metastable/yosano-love-button/README.md

# yosano-love-button
Field hack YOSANO - oryza -  ♥yosano button
