metastable/yosano-love-button/Rev1/BOM.xlsx

Part | Value | Device | Package | Description | 名前 | MF | MPN | OC_AKIZUKI | OC_SENGOKU | OC_MARUTSU | 単価
C1 | 0.1uF | C5/2.5 | C5B2.5 | CAPACITOR | 絶縁ラジアルリード型積層セラミックコンデンサー０．１μＦ５０Ｖ５ｍｍ（１０個入） | 株式会社村田製作所(muRata) | RPEF11H104Z2K1A01B | P-02211 |  |  | 10
C2 | 22uF | C5/2.5 | C5B2.5 | CAPACITOR | 絶縁ラジアルリード型積層セラミックコンデンサ ２２μＦ５０Ｖ５ｍｍ | 株式会社村田製作所(muRata) | RDEC71H226MWK1H03B | P-08156 |  |  | 80
C3 | 1uF | C5/2.5 | C5B2.5 | CAPACITOR | 絶縁ラジアルリード型積層セラミックコンデンサ １μＦ５０Ｖ５ｍｍ | 株式会社村田製作所(muRata) | RDER71H105K2K1H03B | P-08150 |  |  | 20
C4 | 1uF | C5/2.5 | C5B2.5 | CAPACITOR | 絶縁ラジアルリード型積層セラミックコンデンサ １μＦ５０Ｖ５ｍｍ | 株式会社村田製作所(muRata) | RDER71H105K2K1H03B | P-08150 |  |  | 20
C5 | 10uF | C5/2.5 | C5B2.5 | CAPACITOR | 絶縁ラジアルリード型積層セラミックコンデンサ １０μＦ５０Ｖ５ｍｍ | 株式会社村田製作所(muRata) | RDEC71H106K3K1H03B | P-08155 |  |  | 50
C6 | 1uF | C5/2.5 | C5B2.5 | CAPACITOR | 絶縁ラジアルリード型積層セラミックコンデンサ １μＦ５０Ｖ５ｍｍ | 株式会社村田製作所(muRata) | RDER71H105K2K1H03B | P-08150 |  |  | 20
C7 | 1uF | C5/2.5 | C5B2.5 | CAPACITOR | 絶縁ラジアルリード型積層セラミックコンデンサ １μＦ５０Ｖ５ｍｍ | 株式会社村田製作所(muRata) | RDER71H105K2K1H03B | P-08150 |  |  | 20
C8 | 1uF | C5/2.5 | C5B2.5 | CAPACITOR | 絶縁ラジアルリード型積層セラミックコンデンサ １μＦ５０Ｖ５ｍｍ | 株式会社村田製作所(muRata) | RDER71H105K2K1H03B | P-08150 |  |  | 20
C9 | 1uF | C5/2.5 | C5B2.5 | CAPACITOR | 絶縁ラジアルリード型積層セラミックコンデンサ １μＦ５０Ｖ５ｍｍ | 株式会社村田製作所(muRata) | RDER71H105K2K1H03B | P-08150 |  |  | 20
CN1 | BUTTON1 | 04-JST-B4B-XH-A | B4B-XH | JST CONNECTOR | XHコネクタ 基板用ポスト 4P ストレート | 日本圧着端子製造(JST) | B4B-XH-A(LF)(SN) |  |  |  | 42
CN2 | BUTTON2 | 04-JST-B4B-XH-A | B4B-XH | JST CONNECTOR | XHコネクタ 基板用ポスト 4P ストレート | 日本圧着端子製造(JST) | B4B-XH-A(LF)(SN) |  |  |  | 42
CN3 | BUTTON3 | 04-JST-B4B-XH-A | B4B-XH | JST CONNECTOR | XHコネクタ 基板用ポスト 4P ストレート | 日本圧着端子製造(JST) | B4B-XH-A(LF)(SN) |  |  |  | 42
CN4 | I2C | GROVE-CONNECTOR-DIP(4P-2.0) | HW4-2.0 | Grove Connector | Grove用-4ピンコネクタ ストレート(オス)10個入り | Seeed Studio | 110990030 |  |  |  | 10
F1 | POLYSW-50mA RXEF005 | PTCPTH | PTC | Resettable Fuse PTC | ポリスイッチ５０ｍＡ（１００ｍＡで遮断） 耐圧：６０Ｖ ＲＸＥＦ００５ | Littelfuse, Inc./Tyco Electronics Corporation/Raychem | RXEF005 | P-01352 |  |  | 30
F2 | POLYSW-50mA RXEF005 | PTCPTH | PTC | Resettable Fuse PTC | ポリスイッチ５０ｍＡ（１００ｍＡで遮断） 耐圧：６０Ｖ ＲＸＥＦ００５ | Littelfuse, Inc./Tyco Electronics Corporation/Raychem | RXEF005 | P-01352 |  |  | 30
F3 | POLYSW-50mA RXEF005 | PTCPTH | PTC | Resettable Fuse PTC | ポリスイッチ５０ｍＡ（１００ｍＡで遮断） 耐圧：６０Ｖ ＲＸＥＦ００５ | Littelfuse, Inc./Tyco Electronics Corporation/Raychem | RXEF005 | P-01352 |  |  | 30
J1 | DC5V | POWER_JACK | POWER_JACK_PTH | Power Jack Connector | ２．１ｍｍ標準ＤＣジャック 基板取付用 ＭＪ－１７９Ｐ | マル信無線電機株式会社 | MJ-179P | C-00077 |  |  | 40
JP1 | SERIAL | PINHD-1X4 | 1X04 | PIN HEADER | 細ピンヘッダ １×４ | Useconn Electronics Ltd. | PHA-1x4SG | C-04392 |  |  | 5
LED1 |  | LED3MM | LED3MM | LED | ３ｍｍ赤色ＬＥＤ ７０° ＯＳＲ５ＪＡ３Ｚ７４Ａ | OptoSupply | OSR5JA3Z74A | I-11577 |  |  | 10
LED2 |  | LED3MM | LED3MM | LED | ３ｍｍ赤色ＬＥＤ ７０° ＯＳＲ５ＪＡ３Ｚ７４Ａ | OptoSupply | OSR5JA3Z74A | I-11577 |  |  | 10
LED3 |  | LED3MM | LED3MM | LED | ３ｍｍ赤色ＬＥＤ ７０° ＯＳＲ５ＪＡ３Ｚ７４Ａ | OptoSupply | OSR5JA3Z74A | I-11577 |  |  | 10
LED4 | POWER | LED3MM | LED3MM | LED | ３ｍｍ赤色ＬＥＤ ７０° ＯＳＲ５ＪＡ３Ｚ７４Ａ | OptoSupply | OSR5JA3Z74A | I-11577 |  |  | 10
Q1 | BS170 | BSS101 | TO92 | N-Channel Enhancement MOSFET 60V 0,5A | Ｎｃｈ ＭＯＳＦＥＴ ＢＳ１７０ | Fairchild Semiconductor | BSS170 | I-09724 |  |  | 20
Q2 | BS170 | BSS101 | TO92 | N-Channel Enhancement MOSFET 60V 0,5A | Ｎｃｈ ＭＯＳＦＥＴ ＢＳ１７０ | Fairchild Semiconductor | BSS170 | I-09724 |  |  | 20
Q3 | BS170 | BSS101 | TO92 | N-Channel Enhancement MOSFET 60V 0,5A | Ｎｃｈ ＭＯＳＦＥＴ ＢＳ１７０ | Fairchild Semiconductor | BSS170 | I-09724 |  |  | 20
R1 | 10K | R-US_0204/7 | 0204/7 | RESISTOR, American symbol | カーボン抵抗（炭素皮膜抵抗） １／４Ｗ １０ｋΩ （１００本入） | SHIH HAO Electronics CO.,LTD | RD25S 10K | R-25103 |  |  | 1
R2 | 10K | R-US_0204/7 | 0204/7 | RESISTOR, American symbol | カーボン抵抗（炭素皮膜抵抗） １／４Ｗ １０ｋΩ （１００本入） | SHIH HAO Electronics CO.,LTD | RD25S 10K | R-25103 |  |  | 1
R3 | 200K | R-US_0204/7 | 0204/7 | RESISTOR, American symbol | カーボン抵抗（炭素皮膜抵抗） １／４Ｗ ２００ｋΩ （１００本入） | SHIH HAO Electronics CO.,LTD | RD25S 200K | R-25204 |  |  | 1
R4 | 100K | R-US_0204/7 | 0204/7 | RESISTOR, American symbol | カーボン抵抗（炭素皮膜抵抗） １／４Ｗ １００ｋΩ （１００本入） | SHIH HAO Electronics CO.,LTD | RD25S 100K | R-25104 |  |  | 1
R5 | 330R | R-US_0204/7 | 0204/7 | RESISTOR, American symbol | カーボン抵抗（炭素皮膜抵抗） １／４Ｗ ３３０Ω （１００本入） | FAITHFUL LINK INDUSTRIAL CORP. | CF25J330RB | R-25331 |  |  | 1
R6 | 330R | R-US_0204/7 | 0204/7 | RESISTOR, American symbol | カーボン抵抗（炭素皮膜抵抗） １／４Ｗ ３３０Ω （１００本入） | FAITHFUL LINK INDUSTRIAL CORP. | CF25J330RB | R-25331 |  |  | 1
R7 | 10K | R-US_0204/7 | 0204/7 | RESISTOR, American symbol | カーボン抵抗（炭素皮膜抵抗） １／４Ｗ １０ｋΩ （１００本入） | SHIH HAO Electronics CO.,LTD | RD25S 10K | R-25103 |  |  | 1
R8 | 10K | R-US_0204/7 | 0204/7 | RESISTOR, American symbol | カーボン抵抗（炭素皮膜抵抗） １／４Ｗ １０ｋΩ （１００本入） | SHIH HAO Electronics CO.,LTD | RD25S 10K | R-25103 |  |  | 1
R9 | 10K | R-US_0204/7 | 0204/7 | RESISTOR, American symbol | カーボン抵抗（炭素皮膜抵抗） １／４Ｗ １０ｋΩ （１００本入） | SHIH HAO Electronics CO.,LTD | RD25S 10K | R-25103 |  |  | 1
R10 | 0R | R-US_0204/7 | 0204/7 | RESISTOR, American symbol | カーボン抵抗（炭素皮膜抵抗） １／４Ｗ ０Ω （１００本入） | SHIH HAO Electronics CO.,LTD | RD25S 0E | R-25000 |  |  | 1
R11 | 10K | R-US_0204/7 | 0204/7 | RESISTOR, American symbol | カーボン抵抗（炭素皮膜抵抗） １／４Ｗ １０ｋΩ （１００本入） | SHIH HAO Electronics CO.,LTD | RD25S 10K | R-25103 |  |  | 1
R12 | 10K | R-US_0204/7 | 0204/7 | RESISTOR, American symbol | カーボン抵抗（炭素皮膜抵抗） １／４Ｗ １０ｋΩ （１００本入） | SHIH HAO Electronics CO.,LTD | RD25S 10K | R-25103 |  |  | 1
R13 | 0R | R-US_0204/7 | 0204/7 | RESISTOR, American symbol | カーボン抵抗（炭素皮膜抵抗） １／４Ｗ ０Ω （１００本入） | SHIH HAO Electronics CO.,LTD | RD25S 0E | R-25000 |  |  | 1
R14 | 10K | R-US_0204/7 | 0204/7 | RESISTOR, American symbol | カーボン抵抗（炭素皮膜抵抗） １／４Ｗ １０ｋΩ （１００本入） | SHIH HAO Electronics CO.,LTD | RD25S 10K | R-25103 |  |  | 1
R15 | 10K | R-US_0204/7 | 0204/7 | RESISTOR, American symbol | カーボン抵抗（炭素皮膜抵抗） １／４Ｗ １０ｋΩ （１００本入） | SHIH HAO Electronics CO.,LTD | RD25S 10K | R-25103 |  |  | 1
R16 | 0R | R-US_0204/7 | 0204/7 | RESISTOR, American symbol | カーボン抵抗（炭素皮膜抵抗） １／４Ｗ ０Ω （１００本入） | SHIH HAO Electronics CO.,LTD | RD25S 0E | R-25000 |  |  | 1
R17 | 10K | R-US_0204/7 | 0204/7 | RESISTOR, American symbol | カーボン抵抗（炭素皮膜抵抗） １／４Ｗ １０ｋΩ （１００本入） | SHIH HAO Electronics CO.,LTD | RD25S 10K | R-25103 |  |  | 1
R18 | 330R | R-US_0204/7 | 0204/7 | RESISTOR, American symbol | カーボン抵抗（炭素皮膜抵抗） １／４Ｗ ３３０Ω （１００本入） | FAITHFUL LINK INDUSTRIAL CORP. | CF25J330RB | R-25331 |  |  | 1
R19 | 330R | R-US_0204/7 | 0204/7 | RESISTOR, American symbol | カーボン抵抗（炭素皮膜抵抗） １／４Ｗ ３３０Ω （１００本入） | FAITHFUL LINK INDUSTRIAL CORP. | CF25J330RB | R-25331 |  |  | 1
R20 | 330R | R-US_0204/7 | 0204/7 | RESISTOR, American symbol | カーボン抵抗（炭素皮膜抵抗） １／４Ｗ ３３０Ω （１００本入） | FAITHFUL LINK INDUSTRIAL CORP. | CF25J330RB | R-25331 |  |  | 1
R21 | 330R | R-US_0204/7 | 0204/7 | RESISTOR, American symbol | カーボン抵抗（炭素皮膜抵抗） １／４Ｗ ３３０Ω （１００本入） | FAITHFUL LINK INDUSTRIAL CORP. | CF25J330RB | R-25331 |  |  | 1
SW1 | RESET | TVBP06 | TVBP06 | 2pin switch. | タクトスイッチ（黒） | Zhejiang Jianfu Electronics Co., Ltd | TVBP06-B043CB-B | P-08073 |  |  | 20
SW2 | BOOT | TVBP06 | TVBP06 | 2pin switch. | タクトスイッチ（黒） | Zhejiang Jianfu Electronics Co., Ltd | TVBP06-B043CB-B | P-08073 |  |  | 20
U1 | ESP-WROOM-02FRONT-FACE | ESP-WROOM-02FRONT-FACE | FRONT-FACE | WiFi module - ESP-WROOM-02 | Ｗｉ－Ｆｉモジュール ＥＳＰ－ＷＲＯＯＭ－０２ | Espressif Systems (Shanghai) Pte. Ltd. | ESP-WROOM-02 | M-09607 |  |  | 550
U2 | TA48M033F | TA48M033F | DPACK | TA48 series | 低損失三端子レギュレーター ３．３Ｖ５００ｍＡ ＴＡ４８Ｍ０３３Ｆ（Ｓ Ｑ） | 株式会社東芝セミコンダクター社(TOSHIBA) | TA48M033F(S Q) | I-00538 |  |  | 100
U3 | TCM809R | TCM809 | SOT23B-3 | POWER SUPPLY MONITOR | リセットＩＣ ＴＣＭ８０９Ｒ（８個入） | Microchip Technology Inc.(マイクロチップ) | TCM809RVNB | I-02533 |  |  | 25
GOLD_ORB_SM1 | OSHWLOGOLOGO5MM | OSHWLOGOLOGO5MM | OSHW_5MM | The OSHW logo for PCB layout |  |  |  |  |  |  | 0
PCB1 | PCB_DP_RECTANGLE-37X60 | PCB_DP_RECTANGLE-37X60 | DP6037_V1 | Dangerous Prototypes Standard Rectangular PCB sizes |  | PCBGOGO | B67668AS3 60 x 37 |  |  |  | 540.8
 |  |  |  |  | 照光式ゲームスイッチ 30Φ レッド | セイミツ工業 | PSL-30N-5W2-R |  | EEHD-0PLA |  | 1061
 |  |  |  |  | 照光式ゲームスイッチ 30Φ オレンジ | セイミツ工業 | PSL-30N-5W2-O |  | EEHD-0SMS |  | 1061
 |  |  |  |  | 照光式ゲームスイッチ 30Φ ブルー | セイミツ工業 | PSL-30N-5W2-B |  | EEHD-0PLD |  | 1061
 |  |  |  |  | XHコネクタ コンタクト(10個入)【SXH-001T-0.6*10】 | 日本圧着端子製造(JST) | SXH-001T-0.6*10 |  |  | 59201 | 180
 |  |  |  |  | XHコネクタ コンタクト(10個入)【SXH-001T-0.6*10】 | 日本圧着端子製造(JST) | SXH-001T-0.6*10 |  |  | 59201 | 180
 |  |  |  |  | 長方形コネクタ-ハウジング【XHP-4】 | 日本圧着端子製造(JST) | XHP-4 |  |  | 14896331 | 40
 |  |  |  |  | 長方形コネクタ-ハウジング【XHP-4】 | 日本圧着端子製造(JST) | XHP-4 |  |  | 14896331 | 40
 |  |  |  |  | 長方形コネクタ-ハウジング【XHP-4】 | 日本圧着端子製造(JST) | XHP-4 |  |  | 14896331 | 40
 |  |  |  |  | プラスチックケース | タカチ電機 | SW-125B |  | 757L-64F7 |  | 270
 |  |  |  |  |  |  |  |  |  |  | 5840.8
