metastable/yosano-love-button/Rev1/case/CaseProcessingInstruction.dxf

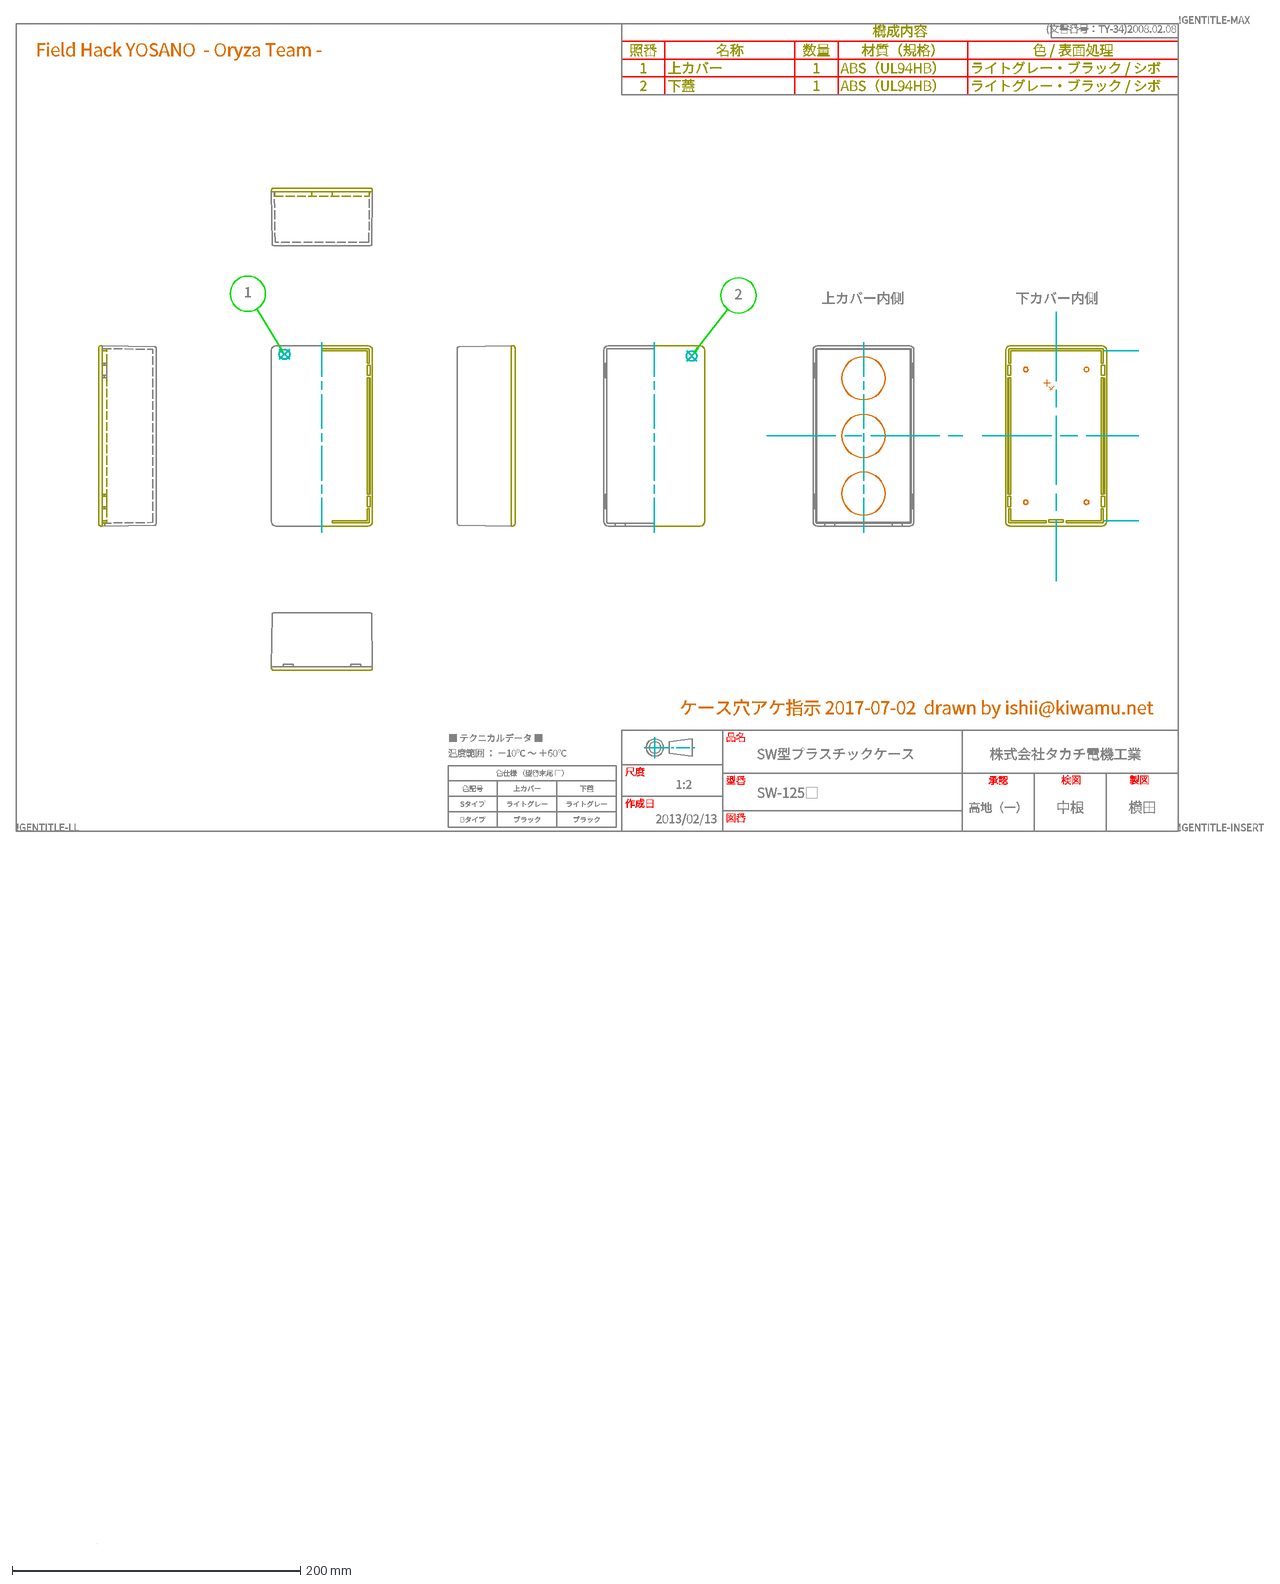
[picture p1: CAD file, 2017-07-02, an earlier design]
Rev1/case/CaseProcessingInstruction.dxf
(文書番号：TY-34)2008.02.08
!GENTITLE-INSERT
!GENTITLE-LL
!GENTITLE-MAX
2013/02/13
SW型プラスチックケース
SW-125□
高地（一）
中根
横田
1:2
製図
検図
承認
株式会社タカチ電機工業
品名
型番
図番
尺度
作成日
1
2
上カバー
ABS（UL94HB）
ライトグレー・ブラック / シボ
下蓋
照番
名称
数量
材質（規格）
色 / 表面処理
構成内容
上カバー内側
下カバー内側
■ テクニカルデータ ■
温度範囲 ： －10℃ ～ ＋60℃
色仕様 （型番末尾 □）
色記号
Sタイプ
ライトグレー
Bタイプ
ブラック
×4
ケース穴アケ指示 2017-07-02 drawn by ishii@kiwamu.net
Field Hack YOSANO - Oryza Team -
