metastable/yosano-love-button/Rev1/eagle/YosanoLoveButton-Schematic.pdf

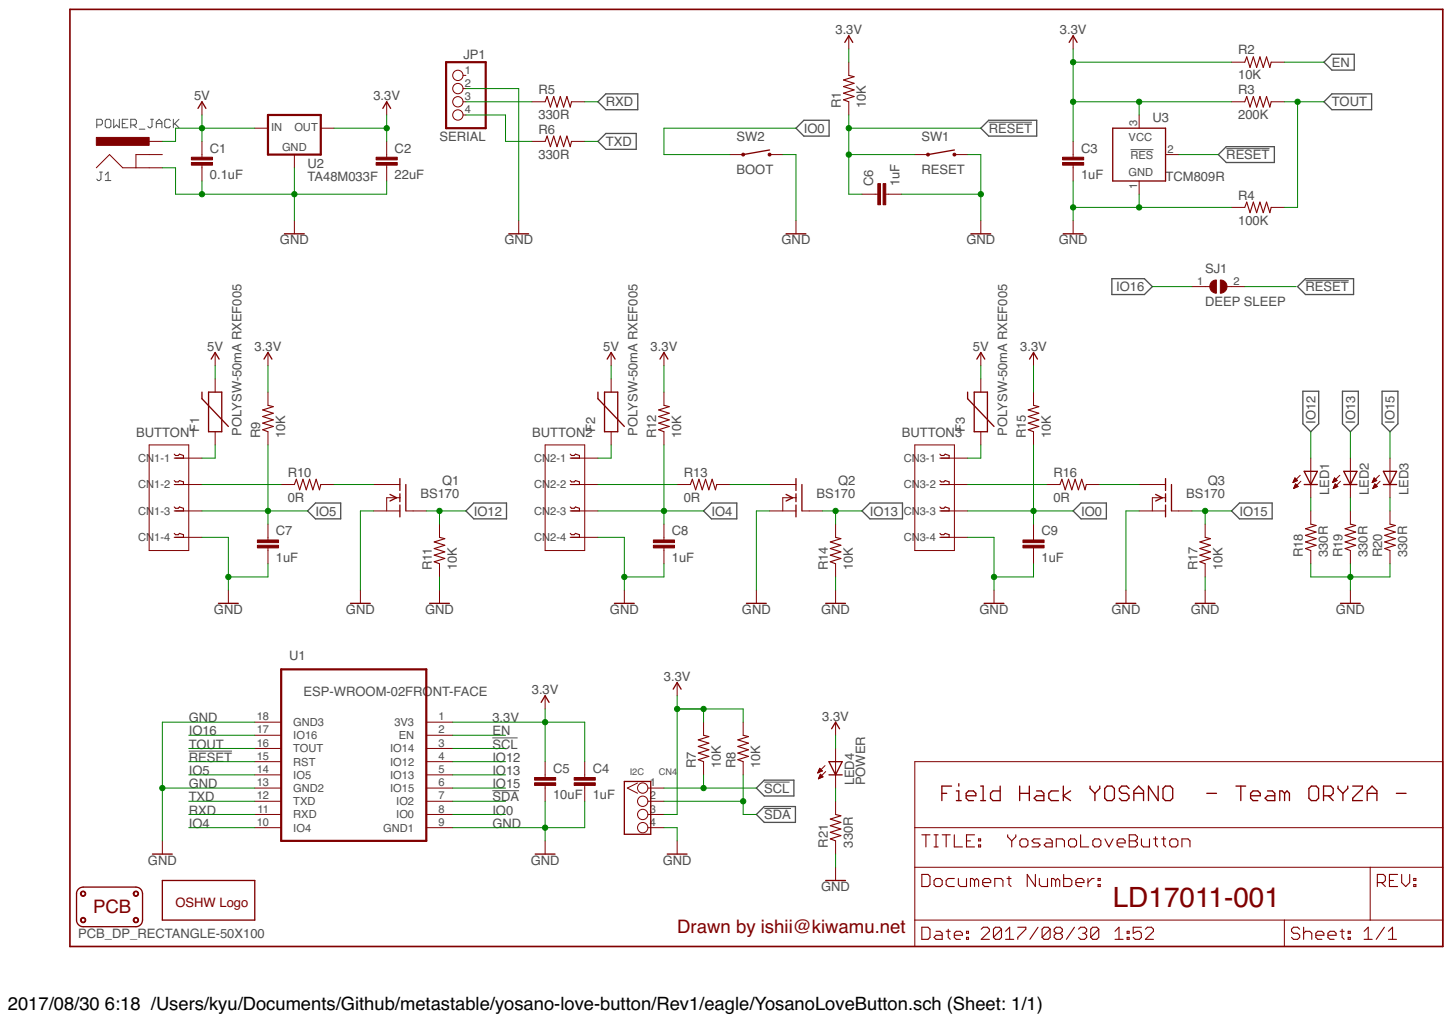
[picture p2: page 1]

Drawn by ishii@kiwamu.net

2017/08/30 6:18 /Users/kyu/Documents/Github/metastable/yosano-love-button/Rev1/eagle/YosanoLoveButton.sch (Sheet: 1/1)
