metastable/yosano-love-button/Rev2/eagle/YosanoLoveButton-Schematic.pdf

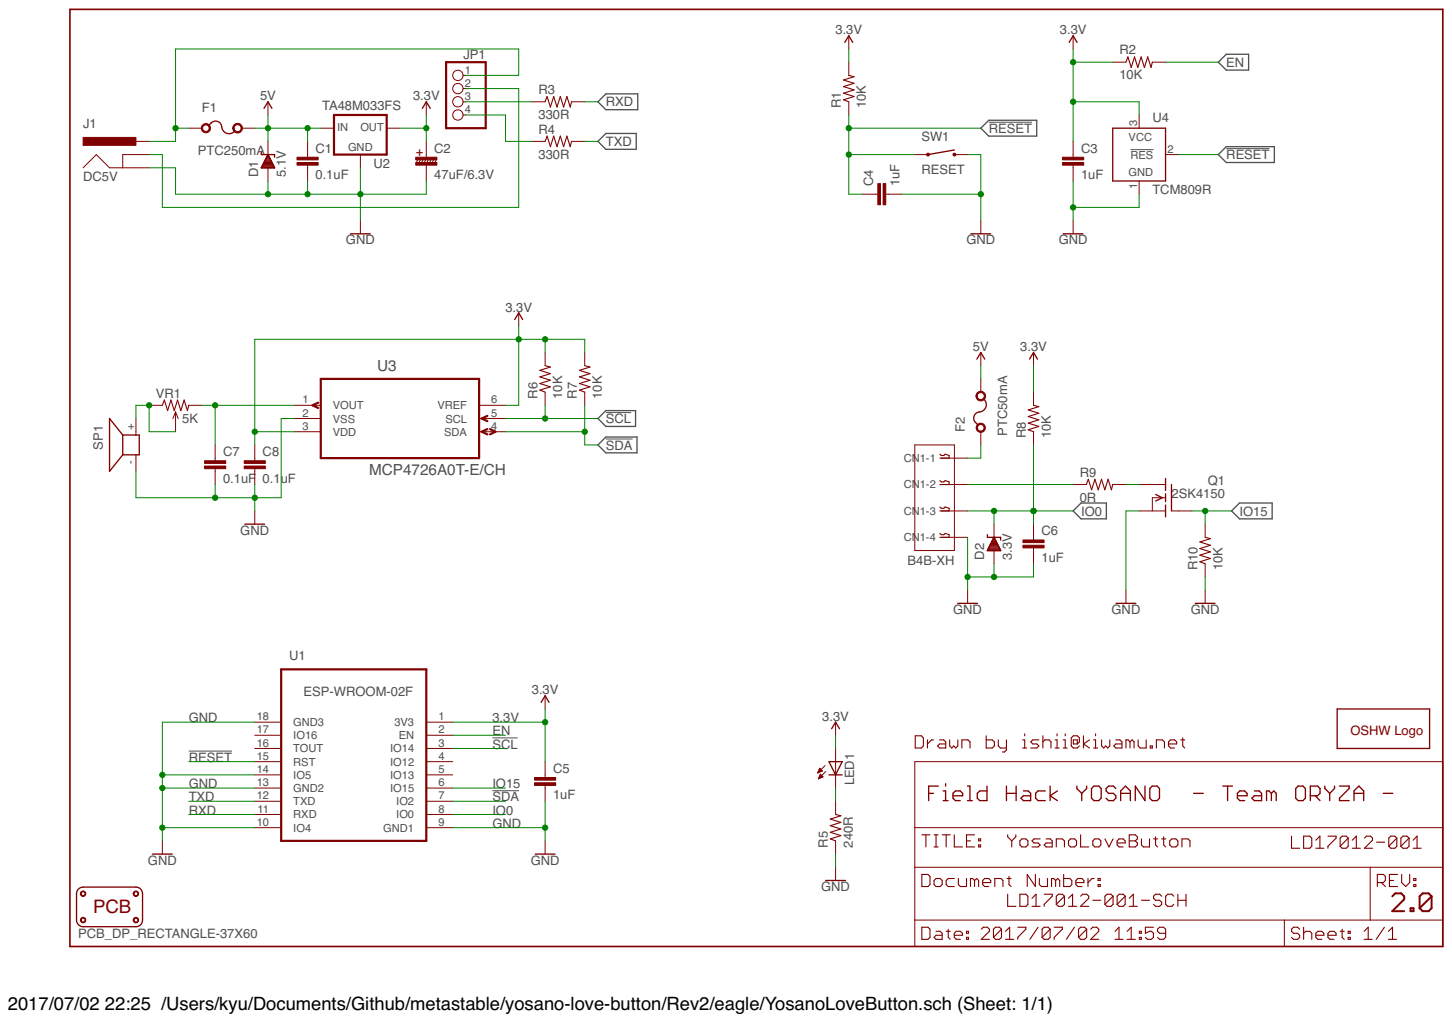
[picture p3: page 1]

2017/07/02 22:25 /Users/kyu/Documents/Github/metastable/yosano-love-button/Rev2/eagle/YosanoLoveButton.sch (Sheet: 1/1)
