metastable/yosano-love-button/Rev1/eagle/YosanoLoveButtonBottom.pdf

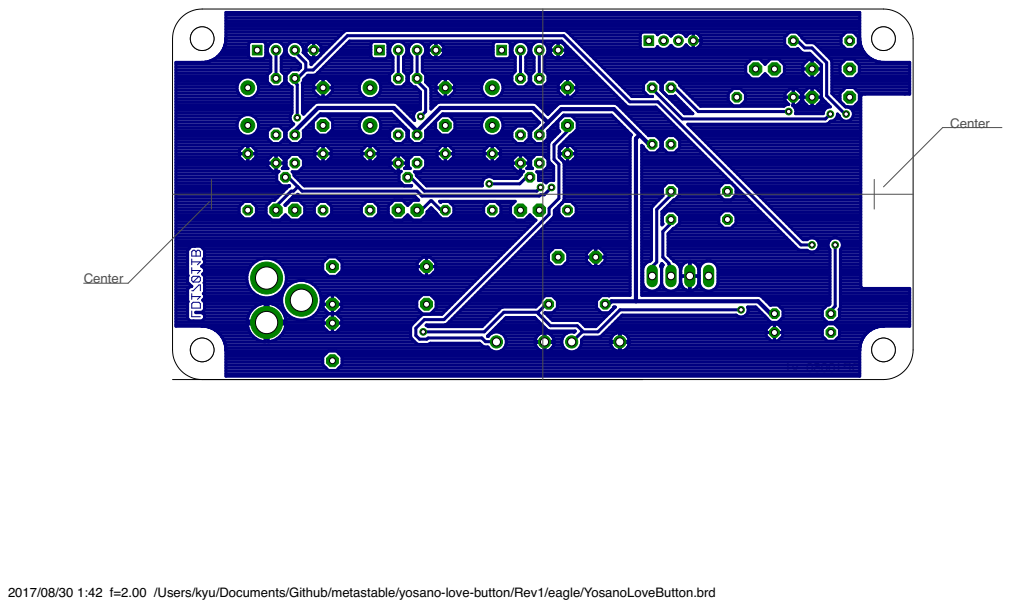
[picture p4: page 1]

2017/08/30 1:42 f=2.00 /Users/kyu/Documents/Github/metastable/yosano-love-button/Rev1/eagle/YosanoLoveButton.brd
