metastable/yosano-love-button/Rev2/eagle/YosanoLoveButton-Board.pdf

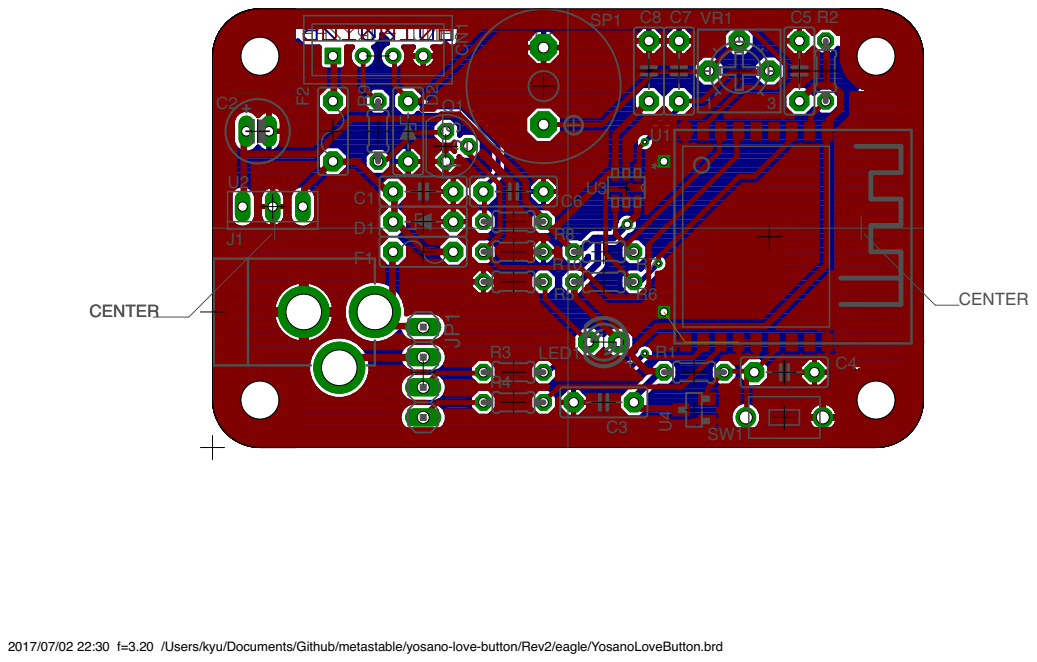
[picture p5: page 1]

2017/07/02 22:30 f=3.20 /Users/kyu/Documents/Github/metastable/yosano-love-button/Rev2/eagle/YosanoLoveButton.brd
