metastable/yosano-love-button/Rev1/case/CaseProcessingInstruction.pdf

### Field Hack YOSANO - Oryza Team -

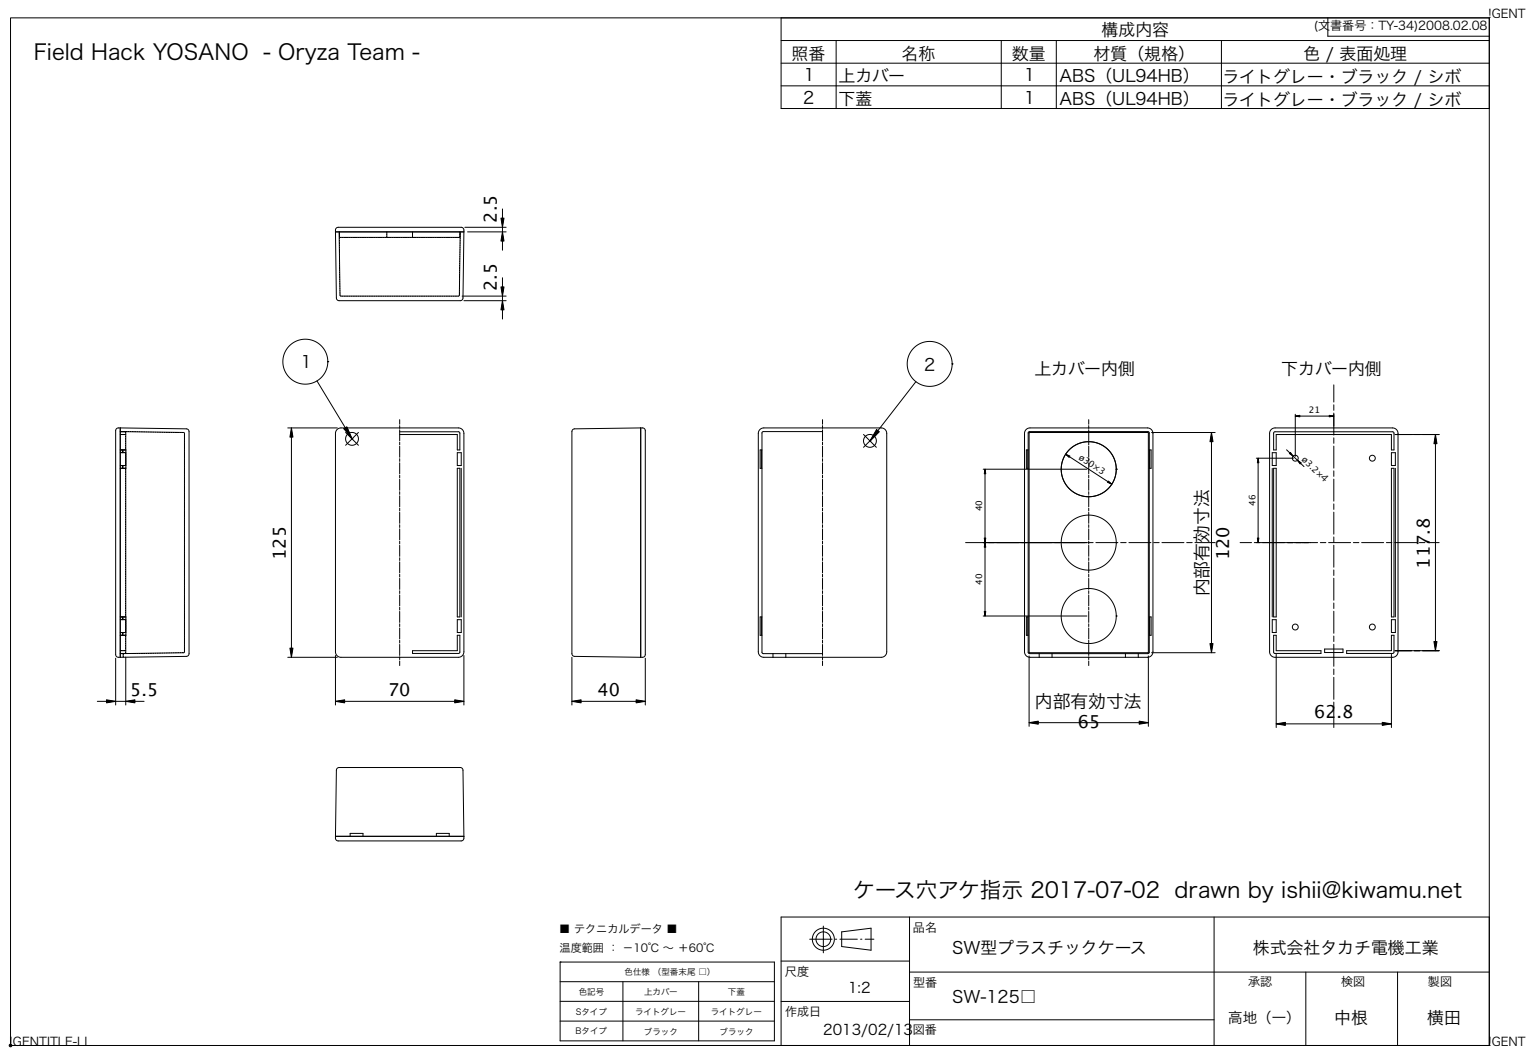
[picture p6: page 1]
(⽂書番号：TY-34)2008.02.08; !GENTITLE-LL; !GENTITLE-INSERT; !GENTITLE-MAX; 構成内容; 内部有効⼨法; 上カバー内側; 下カバー内側; ■ テクニカルデータ ■; 温度範囲 ： －10℃ 〜 ＋60℃; ⾊仕様 （型番末尾 □）; 上カバー; Sタイプ; ライトグレー; Bタイプ; ブラック

照番 | 名称 | 数量 | 材質（規格） | ⾊ / 表⾯処理
1 | 上カバー | 1 | ABS（UL94HB） | ライトグレー・ブラック / シボ
2 | 下蓋 | 1 | ABS（UL94HB） | ライトグレー・ブラック / シボ

ケース⽳アケ指⽰ 2017-07-02 drawn by ishii@kiwamu.net

品名 SW型プラスチックケース | 株式会社タカチ電機⼯業
