metastable/yosano-love-button/Rev3/eagle/YosanoLoveButton.brd

## EAGLE design Rev3/eagle/YosanoLoveButton.brd (2017-08-29)

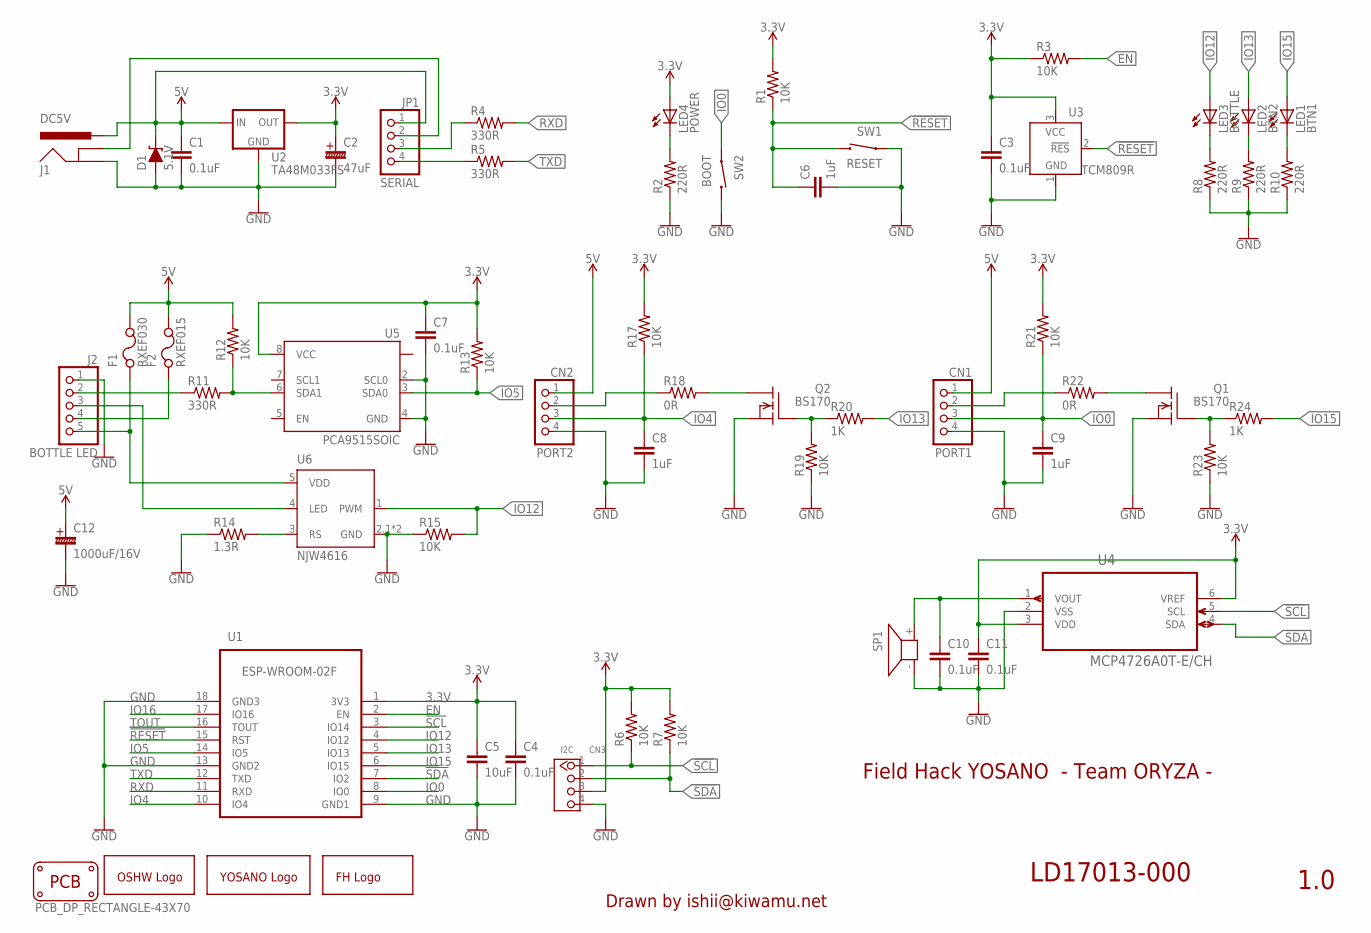
[picture p7: schematic YosanoLoveButton.sch]

Parts:
C1, C3, C4, C7: 0.1uF; C5B2.5
C2: 47uF; E2,0-5
C5: 10uF; C5B2.5
C6, C8, C9: 1uF; C5B2.5
C10, C11: 0.1uF; C5B2.5; MPN RDER72E104K2K1H03B
C12: 1000uF/16V; E5,0-10
CN1: PORT1; B4B-XH
CN2: PORT2; B4B-XH
CN3: I2C; HW4-2.0
D1: 5.1V; ZDIO-5-LD
F1: RXEF030; PTC-PTH
F2: RXEF015; PTC-PTH
GOLD_ORB_SM1: OSHWLOGOLOGO5MM; OSHW_5MM
J1: DC5V; POWER_JACK_PTH
J2: BOTTLE LED; MD-50SM
JP1: SERIAL; 1X04
LED1: BTN1; LED3MM
LED2: BTN2; LED3MM
LED3: BOTTLE; LED3MM
LED4: POWER; LED3MM
PCB1: PCB_DP_RECTANGLE-43X70; DP7043_V1
Q1, Q2: BS170; TO92
R1, R3, R6, R7, R12, R13, R15, R17, R19, R21, R23: 10K; 0204/5
R2, R8, R9, R10: 220R; 0204/5
R4, R5, R11: 330R; 0204/5
R14: 1.3R; 0204/5
R18, R22: 0R; 0204/5
R20, R24: 1K; 0204/5
SP1: PKM13EPYH4000
SW1: RESET; TVBP06
SW2: BOOT; TVBP06
U1: ESP-WROOM-02F; FRONT-FACE
U2: TA48M033FS; HSIP3
U3: TCM809R; SOT23B-3
U4: MCP4726A0T-E/CH; SOT95P270X145-6N
U5: PCA9515SOIC; SO08
U6: NJW4616; SOT-89-5
U$1: YOSANOLOGO; YOSANOCHO
U$2: FHLOGO; FIELDHACK-YOSANO

Connections:
3.3V: C2.+, C3.1, C4.1, C5.1, C7.1, C11.1, CN3.3, LED4.A, R1.2, R3.1, R6.2, R7.2, R13.2, R17.2, R21.2, U1.1 (3V3), U2.P$2 (OUT), U3.3 (VCC), U4.3 (VDD), U4.6 (VREF), U5.8 (VCC)
5V: C1.1, C12.+, CN1.1, CN2.1, D1.C, F1.2, F2.2, J1.PWR, JP1.1, R12.2, U2.P$1 (IN)
!RESET: C6.1, R1.1, SW1.2, U1.15 (RST), U3.2 (!RES)
!SCL: CN3.1, R6.1, U1.3 (IO14), U4.5 (SCL)
!SDA: CN3.2, R7.1, U1.7 (IO2), U4.4 (SDA)
EN: R3.2, U1.2 (EN)
GND: C1.2, C2.-, C3.2, C4.2, C5.2, C6.2, C7.2, C8.2, C9.2, C10.2, C11.2, C12.-, CN1.4, CN2.4, CN3.4, D1.A, J1.GND, J2.1, Q1.1 (S), Q2.1 (S), R2.1, R8.1, R9.1, R10.1, R14.1, R15.1, R19.1, R23.1, SP1.- (2), SW1.1, SW2.2, U1.9 (GND1), U1.13 (GND2), U1.18 (GND3), U2.P$3 (GND), U3.1 (GND), U4.2 (VSS), U5.2 (SCL0), U5.4 (GND), U6.2.1 (GND), U6.2.2 (GND)
IO0: C9.1, CN1.3, R21.1, SW2.1, U1.8 (IO0)
IO4: C8.1, CN2.3, R17.1, U1.10 (IO4)
IO5: R13.1, U1.14 (IO5), U5.3 (SDA0)
IO12: LED3.A, R15.2, U1.4 (IO12), U6.1 (PWM)
IO13: LED2.A, R20.2, U1.5 (IO13)
IO15: LED1.A, R24.2, U1.6 (IO15)
IO16: U1.17 (IO16)
unnamed: LED3.K (C), R8.2
unnamed: LED4.K (C), R2.2
unnamed: JP1.4, R5.1
unnamed: R14.2, U6.3 (RS)
unnamed: JP1.3, R4.1
unnamed: LED2.K (C), R9.2
unnamed: LED1.K (C), R10.2
unnamed: F1.1, J2.5, U6.5 (VDD)
unnamed: J2.3, U6.4 (LED)
unnamed: J1.GNDBREAK, JP1.2
unnamed: Q2.3 (D), R18.2
unnamed: J2.2, R11.1
unnamed: CN2.2, R18.1
unnamed: Q2.2 (G), R19.2, R20.1
unnamed: Q1.3 (D), R22.2
unnamed: C10.1, SP1.+ (1), U4.1 (VOUT)
unnamed: F2.1, J2.4
unnamed: Q1.2 (G), R23.2, R24.1
unnamed: CN1.2, R22.1
unnamed: R11.2, R12.1, U5.6 (SDA1)
RXD: R4.2, U1.11 (RXD)
TOUT: U1.16 (TOUT)
TXD: R5.2, U1.12 (TXD)

Notes on the sheet:
Field Hack YOSANO - Team ORYZA -
LD17013-000
Drawn by ishii@kiwamu.net
1.0

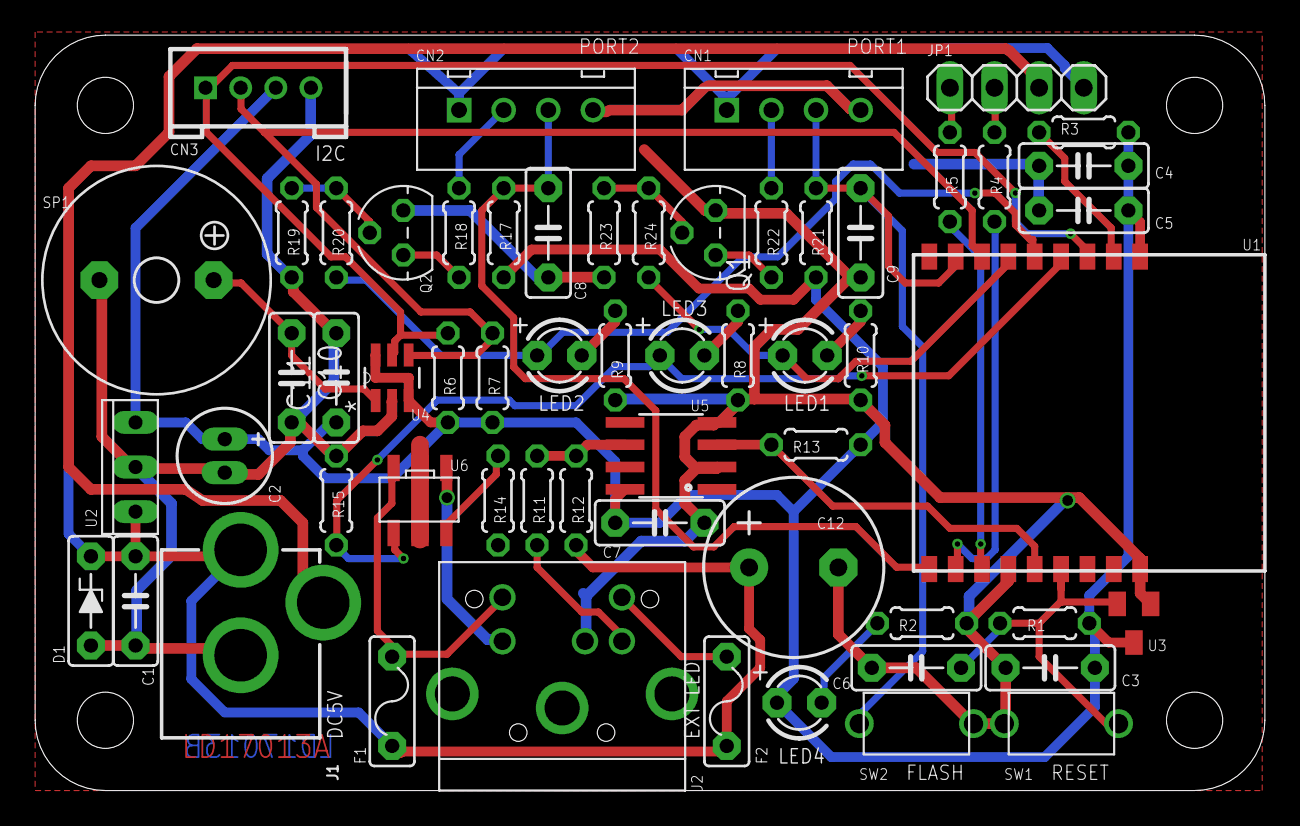
[picture p8: board Rev3/eagle/YosanoLoveButton.brd from above]

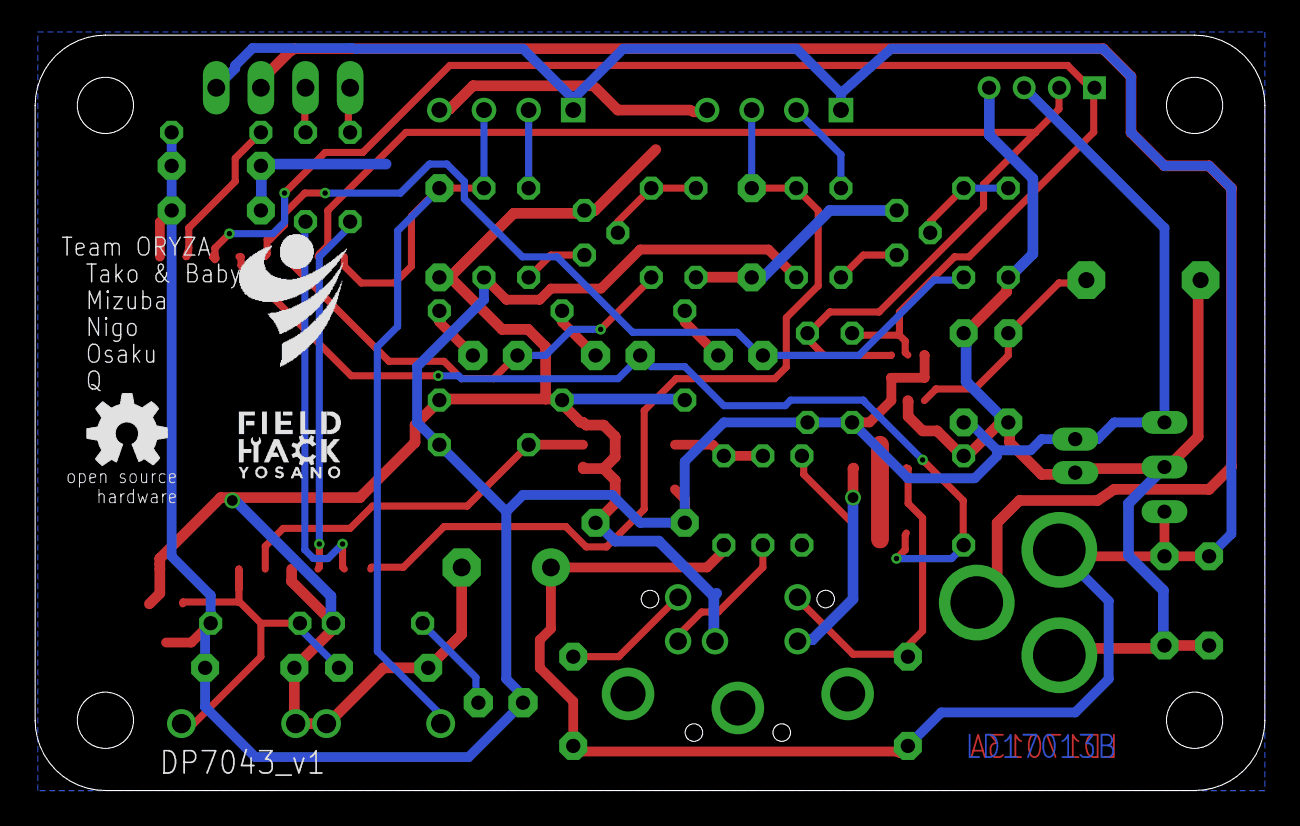
[picture p9: board Rev3/eagle/YosanoLoveButton.brd from below]

Board: 2 copper layers, 70.0 x 43.0 mm, 63 parts (3 on the bottom side), 35 nets.
