metastable/yosano-love-button/Rev1/eagle/YosanoLoveButton.brd

## EAGLE design Rev1/eagle/YosanoLoveButton.brd (2017-07-02, an earlier design)

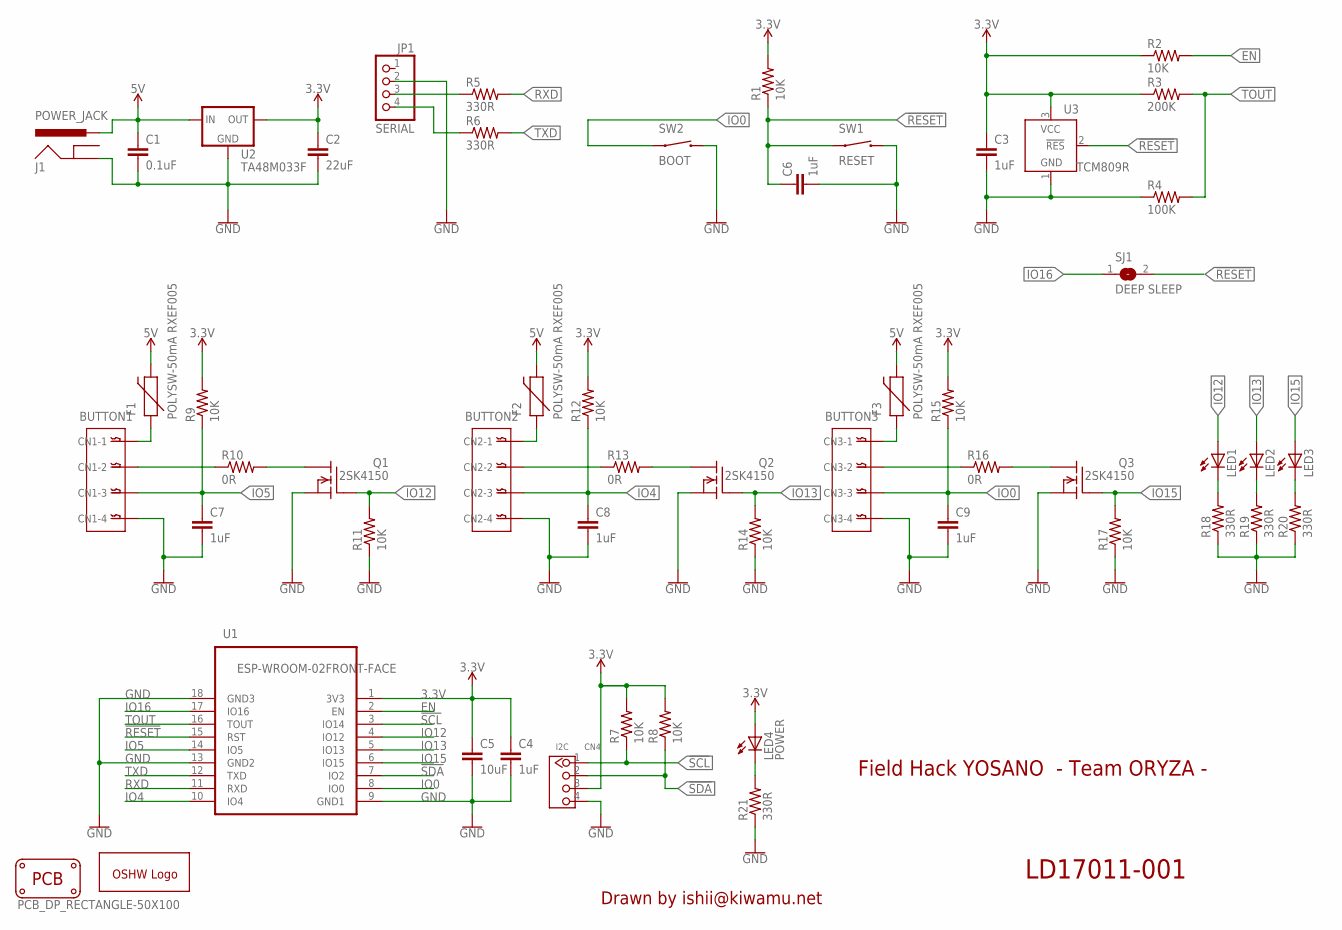
[picture p10: schematic YosanoLoveButton.sch]

Parts:
C1: 0.1uF; C5B2.5
C2: 22uF; C5B2.5
C3, C4, C6, C7, C8, C9: 1uF; C5B2.5
C5: 10uF; C5B2.5
CN1: BUTTON1; B4B-XH
CN2: BUTTON2; B4B-XH
CN3: BUTTON3; B4B-XH
CN4: I2C; HW4-2.0
F1, F2, F3: POLYSW-50mA RXEF005; PTC
GOLD_ORB_SM1: OSHWLOGOLOGO5MM; OSHW_5MM
J1: POWER_JACK; POWER_JACK_PTH
JP1: SERIAL; 1X04
LED1, LED2, LED3: LED3MM
LED4: POWER; LED3MM
PCB1: PCB_DP_RECTANGLE-50X100; DP10050_V1
Q1, Q2, Q3: 2SK4150; TO92
R1, R2, R7, R8, R9, R11, R12, R14, R15, R17: 10K; 0204/7
R3: 200K; 0204/7
R4: 100K; 0204/7
R5, R6, R18, R19, R20, R21: 330R; 0204/7
R10, R13, R16: 0R; 0204/7
SJ1: DEEP SLEEP; SOLDERJUMPER_REFLOW
SW1: RESET; TVBP06
SW2: BOOT; TVBP06
U1: ESP-WROOM-02FRONT-FACE; FRONT-FACE
U2: TA48M033F; DPACK
U3: TCM809R; SOT23B-3

Connections:
3.3V: C2.1, C3.1, C4.1, C5.1, CN4.3, LED4.A, R1.2, R2.1, R3.1, R7.2, R8.2, R9.2, R12.2, R15.2, U1.1 (3V3), U2.3 (OUT), U3.3 (VCC)
5V: C1.1, F1.P$2 (2), F2.P$2 (2), F3.P$2 (2), J1.PWR, U2.1 (IN)
!RESET: C6.1, R1.1, SJ1.2, SW1.1, U1.15 (RST), U3.2 (!RES)
!SCL: CN4.1, R7.1, U1.3 (IO14)
!SDA: CN4.2, R8.1, U1.7 (IO2)
EN: R2.2, U1.2 (EN)
GND: C1.2, C2.2, C3.2, C4.2, C5.2, C6.2, C7.2, C8.2, C9.2, CN1.P$4, CN2.P$4, CN3.P$4, CN4.4, J1.GND, JP1.2, Q1.1 (S), Q2.1 (S), Q3.1 (S), R4.1, R11.1, R14.1, R17.1, R18.1, R19.1, R20.1, R21.1, SW1.2, SW2.2, U1.9 (GND1), U1.13 (GND2), U1.18 (GND3), U2.4 (GND), U3.1 (GND)
IO0: C9.1, CN3.P$3, R15.1, SW2.1, U1.8 (IO0)
IO4: C8.1, CN2.P$3, R12.1, U1.10 (IO4)
IO5: C7.1, CN1.P$3, R9.1, U1.14 (IO5)
IO12: LED1.A, Q1.2 (G), R11.2, U1.4 (IO12)
IO13: LED2.A, Q2.2 (G), R14.2, U1.5 (IO13)
IO15: LED3.A, Q3.2 (G), R17.2, U1.6 (IO15)
IO16: SJ1.1, U1.17 (IO16)
unnamed: LED1.K (C), R18.2
unnamed: LED4.K (C), R21.2
unnamed: JP1.4, R6.1
unnamed: Q1.3 (D), R10.2
unnamed: JP1.3, R5.1
unnamed: LED2.K (C), R19.2
unnamed: LED3.K (C), R20.2
unnamed: CN1.P$1, F1.P$1 (1)
unnamed: CN1.P$2, R10.1
unnamed: Q2.3 (D), R13.2
unnamed: CN2.P$1, F2.P$1 (1)
unnamed: CN2.P$2, R13.1
unnamed: Q3.3 (D), R16.2
unnamed: CN3.P$1, F3.P$1 (1)
unnamed: CN3.P$2, R16.1
RXD: R5.2, U1.11 (RXD)
TOUT: R3.2, R4.2, U1.16 (TOUT)
TXD: R6.2, U1.12 (TXD)

Notes on the sheet:
Field Hack YOSANO - Team ORYZA -
LD17011-001
Drawn by ishii@kiwamu.net

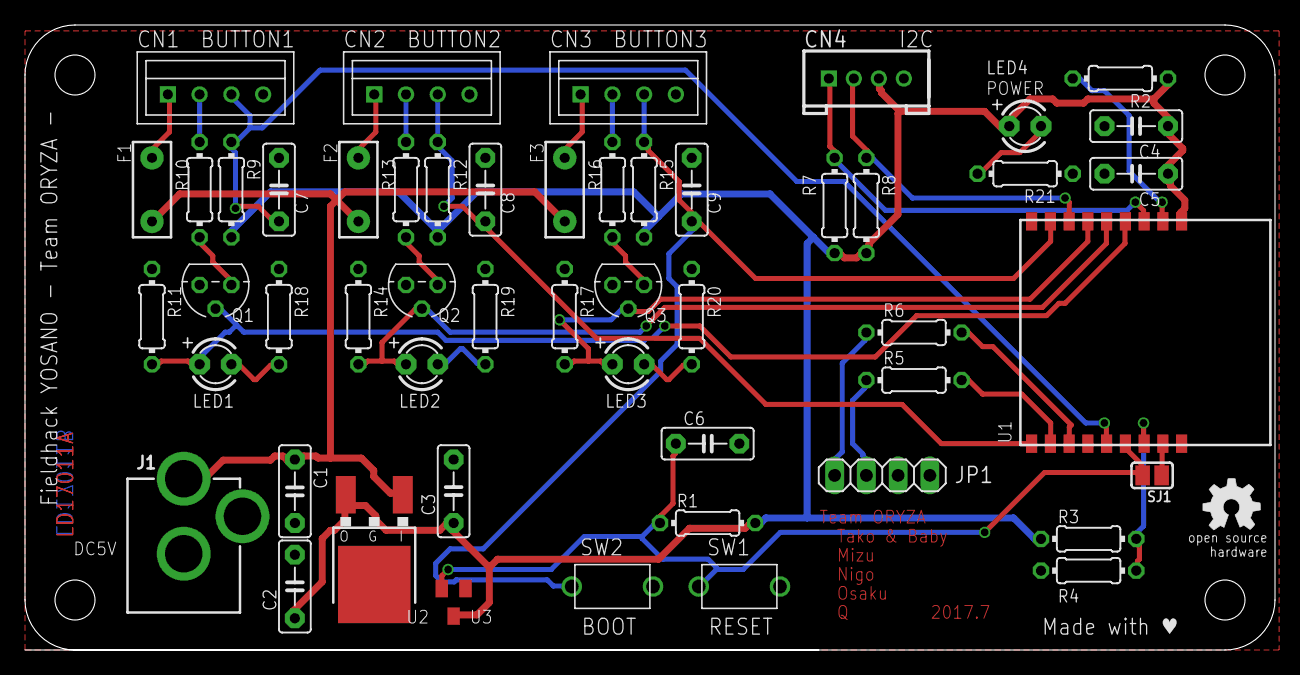
[picture p11: board Rev1/eagle/YosanoLoveButton.brd from above]

Board: 2 copper layers, 100.0 x 50.0 mm, 54 parts (0 on the bottom side), 32 nets.
