metastable/yosano-love-button/Rev2/eagle/YosanoLoveButton.brd

## EAGLE design Rev2/eagle/YosanoLoveButton.brd (2017-07-02, an earlier design)

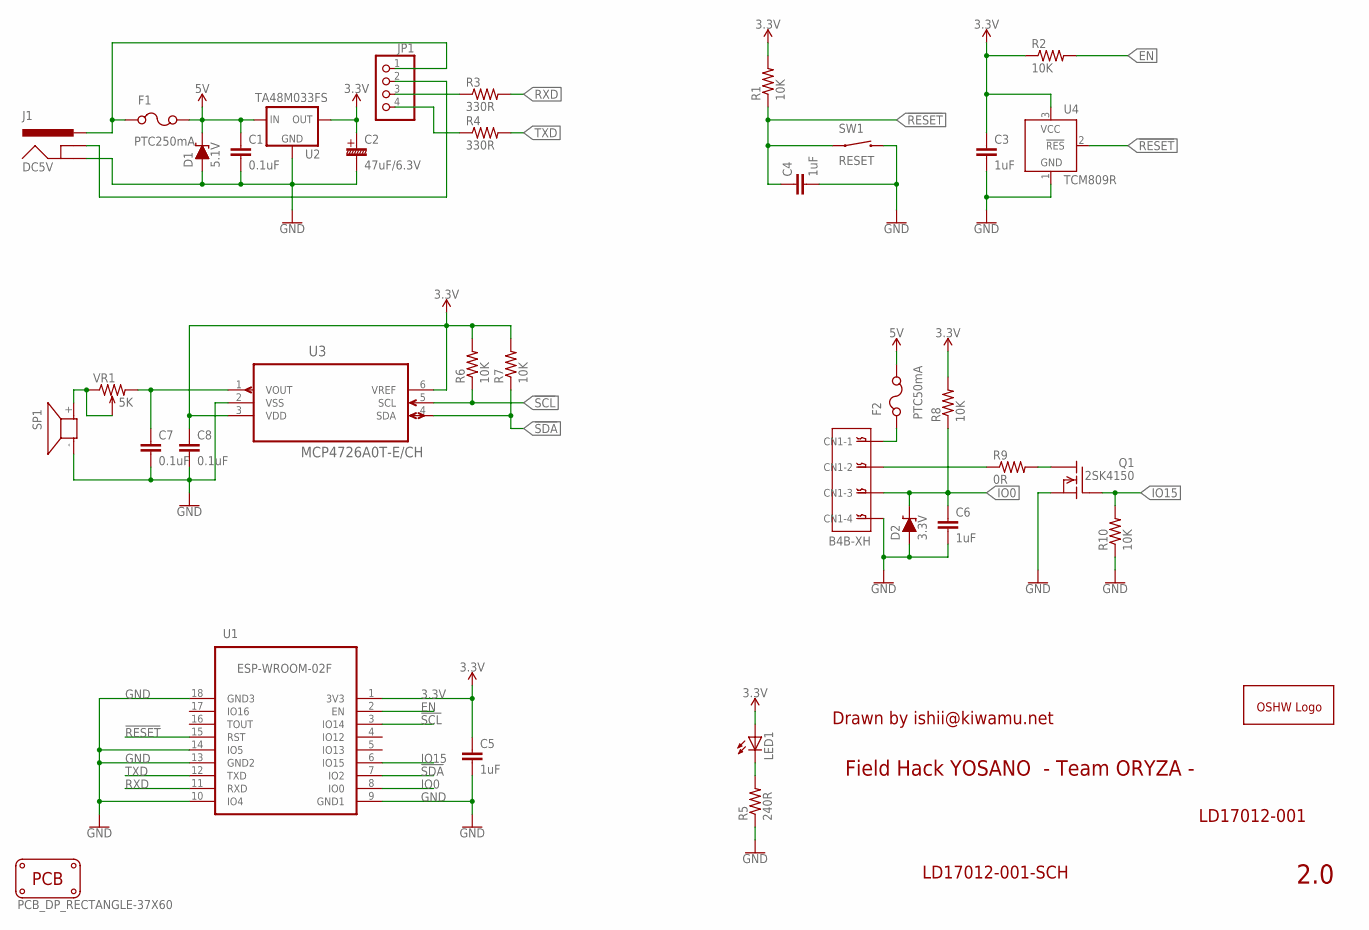
[picture p12: schematic YosanoLoveButton.sch]

Parts:
C1, C7, C8: 0.1uF; C5B2.5; MPN RDER72E104K2K1H03B
C2: 47uF/6.3V; E2,0-5; MPN 0JUTCX470M
C3, C4, C5, C6: 1uF; C5B2.5; MPN RDER71H105K2K1H03B
CN1: B4B-XH
D1: 5.1V; ZDIO-5-LD; MPN GDZJ5.1B
D2: 3.3V; ZDIO-5-LD; MPN GDZJ3.3B
F1: PTC250mA; PTC-PTH; MPN RXEF005
F2: PTC50mA; PTC-PTH; MPN RXEF005
GOLD_ORB_SM1: OSHWLOGOLOGO5MM; OSHW_5MM
J1: DC5V; POWER_JACK_PTH
JP1: PINHD-1X4; 1X04
LED1: LED3MM; MPN OSR5JA3Z74A
PCB1: PCB_DP_RECTANGLE-37X60; DP6037_V1
Q1: 2SK4150; TO92
R1, R2, R6, R7, R8, R10: 10K; 0204/5; MPN RD25SJ10K
R3: 330R; 0204/5; MPN RD25SJ330R
R4: 330R; 0204/5; MPN RD25SJ300R
R5: 240R; 0204/5; MPN RD25SJ 240R
R9: 0R; 0204/5; MPN RD25SP 0R
SP1: PKM13EPYH4000
SW1: RESET; TVBP06
U1: ESP-WROOM-02F; FRONT-FACE
U2: TA48M033FS; HSIP3
U3: MCP4726A0T-E/CH; SOT95P270X145-6N
U4: TCM809R; SOT23B-3
VR1: 5K; 3362P

Connections:
3.3V: C2.+, C3.1, C5.1, C8.1, LED1.A, R1.2, R2.1, R6.2, R7.2, R8.2, U1.1 (3V3), U2.P$2 (OUT), U3.3 (VDD), U3.6 (VREF), U4.3 (VCC)
5V: C1.1, D1.C, F1.2, F2.2, U2.P$1 (IN)
!RESET: C4.1, R1.1, SW1.1, U1.15 (RST), U4.2 (!RES)
!SCL: R6.1, U1.3 (IO14), U3.5 (SCL)
!SDA: R7.1, U1.7 (IO2), U3.4 (SDA)
EN: R2.2, U1.2 (EN)
GND: C1.2, C2.-, C3.2, C4.2, C5.2, C6.2, C7.2, C8.2, CN1.P$4, D1.A, D2.A, J1.GND, Q1.1 (S), R5.1, R10.1, SP1.- (2), SW1.2, U1.9 (GND1), U1.10 (IO4), U1.13 (GND2), U1.14 (IO5), U1.18 (GND3), U2.P$3 (GND), U3.2 (VSS), U4.1 (GND)
IO0: C6.1, CN1.P$3, D2.C, R8.1, U1.8 (IO0)
IO15: Q1.2 (G), R10.2, U1.6 (IO15)
unnamed: F1.1, J1.PWR, JP1.1
unnamed: LED1.K (C), R5.2
unnamed: JP1.4, R4.1
unnamed: C7.1, U3.1 (VOUT), VR1.3
unnamed: JP1.3, R3.1
unnamed: SP1.+ (1), VR1.1, VR1.2
unnamed: J1.GNDBREAK, JP1.2
unnamed: Q1.3 (D), R9.2
unnamed: CN1.P$1, F2.1
unnamed: CN1.P$2, R9.1
RXD: R3.2, U1.11 (RXD)
TXD: R4.2, U1.12 (TXD)

Notes on the sheet:
Field Hack YOSANO - Team ORYZA -
LD17012-001
Drawn by ishii@kiwamu.net
2.0
LD17012-001-SCH

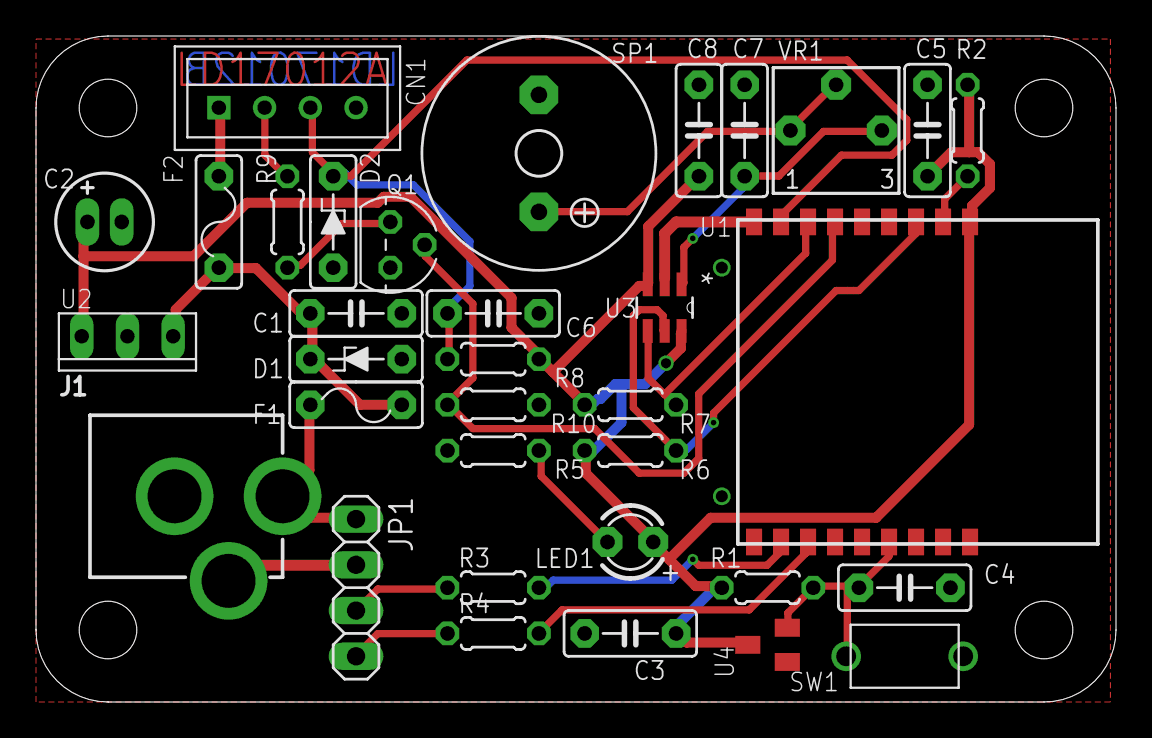
[picture p13: board Rev2/eagle/YosanoLoveButton.brd from above]

Board: 2 copper layers, 60.0 x 37.0 mm, 36 parts (1 on the bottom side), 21 nets.
